AgustinJPG/Control-Hitbox/README.md

En este github tengo todos los archivos de mi proyecto de control hitbox en donde trabaje el codigo
con la libreria keyboard.h, ademas de trabajar el esquematico y el pcb de la placa.
Mas detalles e informacion en el pdf.
