AgustinJPG/Control-Hitbox/HitBox/HitBox.kicad_pcb

## KiCad design HitBox/HitBox.kicad_pcb (2025-11-30)

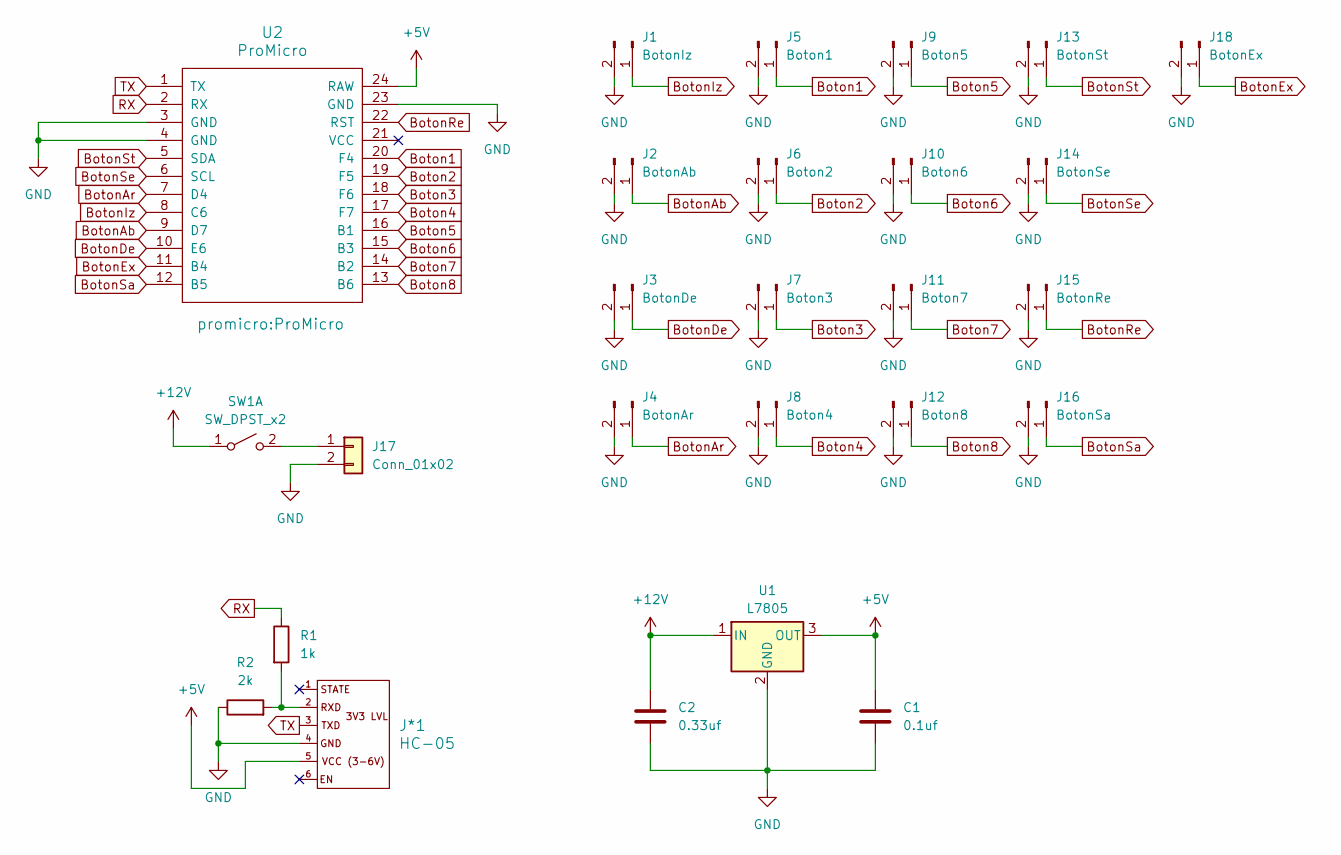
[picture p6: schematic HitBox.kicad_sch]

Parts:
C1: 0.1uf; C_0805_2012Metric
C2: 0.33uf; C_0805_2012Metric
J1: BotonIz; PinHeader_1x02_P2.54mm_Vertical
J2: BotonAb; PinHeader_1x02_P2.54mm_Vertical
J3: BotonDe; PinHeader_1x02_P2.54mm_Vertical
J4: BotonAr; PinHeader_1x02_P2.54mm_Vertical
J5: Boton1; PinHeader_1x02_P2.54mm_Vertical
J6: Boton2; PinHeader_1x02_P2.54mm_Vertical
J7: Boton3; PinHeader_1x02_P2.54mm_Vertical
J8: Boton4; PinHeader_1x02_P2.54mm_Vertical
J9: Boton5; PinHeader_1x02_P2.54mm_Vertical
J10: Boton6; PinHeader_1x02_P2.54mm_Vertical
J11: Boton7; PinHeader_1x02_P2.54mm_Vertical
J12: Boton8; PinHeader_1x02_P2.54mm_Vertical
J13: BotonSt; PinHeader_1x02_P2.54mm_Vertical
J14: BotonSe; PinHeader_1x02_P2.54mm_Vertical
J15: BotonRe; PinHeader_1x02_P2.54mm_Vertical
J16: BotonSa; PinHeader_1x02_P2.54mm_Vertical
J17: Conn_01x02; TerminalBlock_MaiXu_MX126-5.0-02P_1x02_P5.00mm
J18: BotonEx; PinHeader_1x02_P2.54mm_Vertical
J*1: HC-05
R1: 1k; C_0805
R2: 2k; C_0805
SW1: SW_DPST_x2; SW_PUSH_1P1T_6x3.5mm_H5.0_APEM_MJTP1250
U1: L7805; TO-263-3_TabPin2
U2: ProMicro

Connections:
+5V: C1.1, J*1.5, U1.3 (OUT), U2.24 (RAW)
+12V: C2.1, SW1.1 (A), U1.1 (IN)
Boton1: J5.1, U2.20 (F4)
Boton2: J6.1, U2.19 (F5)
Boton3: J7.1, U2.18 (F6)
Boton4: J8.1, U2.17 (F7)
Boton5: J9.1, U2.16 (B1)
Boton6: J10.1, U2.15 (B3)
Boton7: J11.1, U2.14 (B2)
Boton8: J12.1, U2.13 (B6)
BotonAb: J2.1, U2.9 (D7)
BotonAr: J4.1, U2.7 (D4)
BotonDe: J3.1, U2.10 (E6)
BotonEx: J18.1, U2.11 (B4)
BotonIz: J1.1, U2.8 (C6)
BotonRe: J15.1, U2.22 (RST)
BotonSa: J16.1, U2.12 (B5)
BotonSe: J14.1, U2.6 (SCL)
BotonSt: J13.1, U2.5 (SDA)
GND: C1.2, C2.2, J1.2, J2.2, J3.2, J4.2, J5.2, J6.2, J7.2, J8.2, J9.2, J10.2, J11.2, J12.2, J13.2, J14.2, J15.2, J16.2, J17.2, J18.2, J*1.4, R2.1, U1.2 (GND), U2.3 (GND), U2.4 (GND), U2.23 (GND)
unnamed: J17.1, SW1.2 (B)
unnamed: J*1.2, R1.2, R2.2
RX: R1.1, U2.2 (RX)
TX: J*1.3, U2.1 (TX)

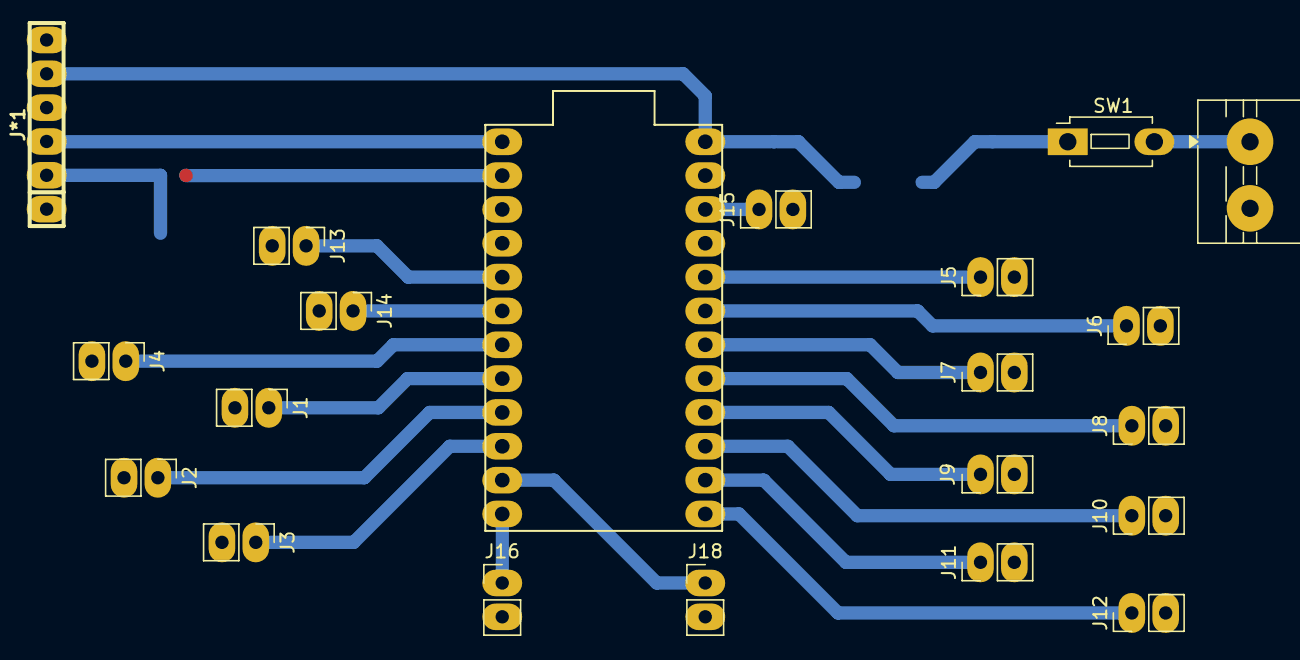
[picture p7: board HitBox.kicad_pcb from above]

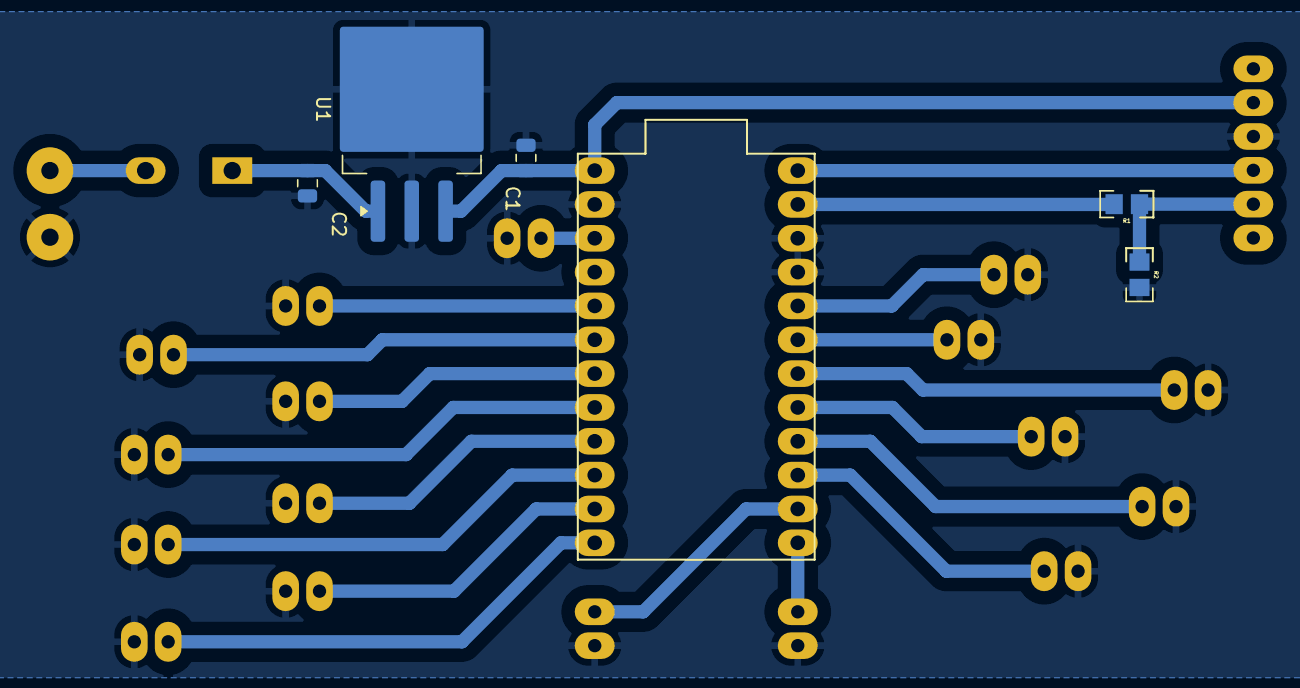
[picture p8: board HitBox.kicad_pcb from below]

Board: 2 copper layers, 26 parts (5 on the bottom side), 24 nets.
